HeyPCB/iris-ring/img/iris_ring_3d.jpg

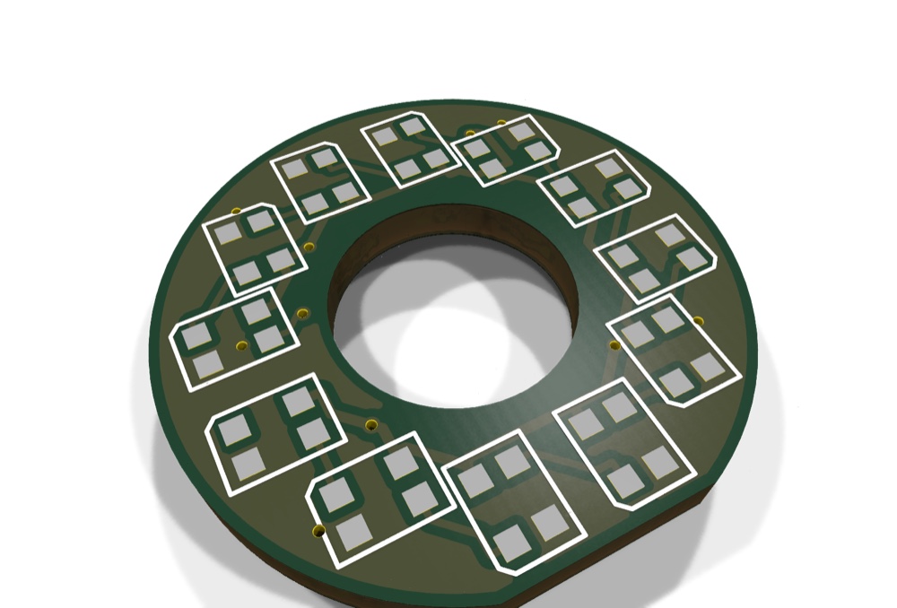
img/iris_ring_3d.jpg
