HeyPCB/iris-ring/media/bottom.png

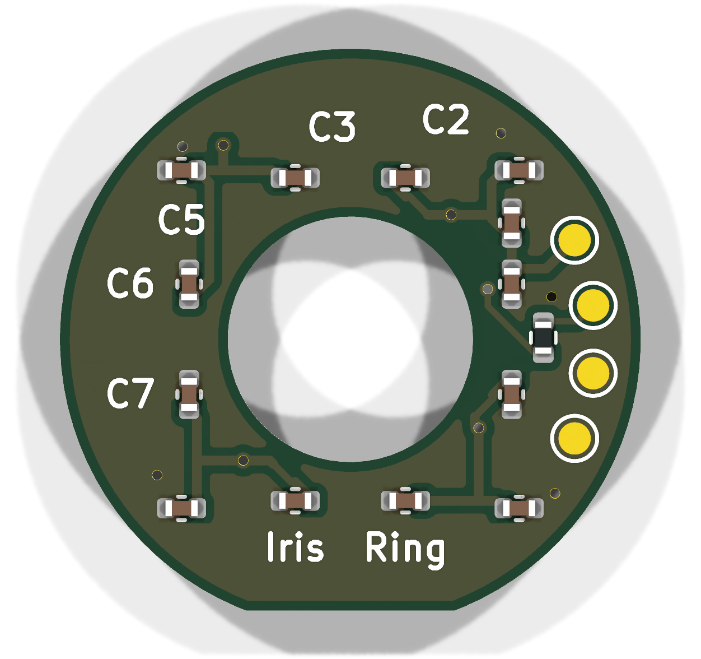
media/bottom.png
