HeyPCB/iris-ring/media/top.png

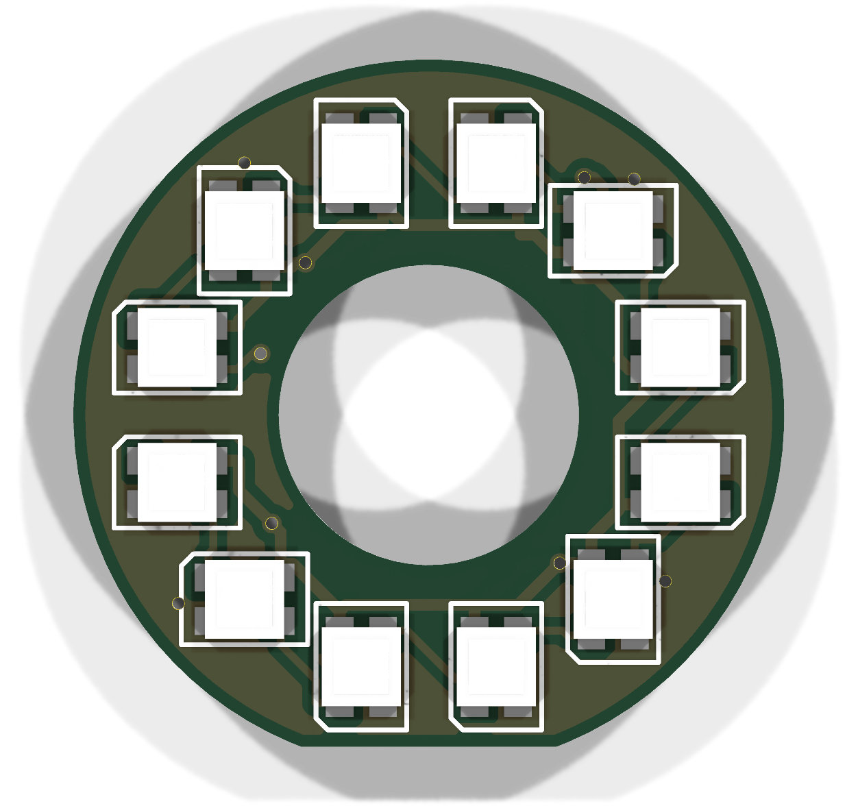
media/top.png
