HeyPCB/iris-ring/fab/iris_ring_bom.csv

Reference | Value | Footprint | MPN | LCSC | Qty
C1,C2,C3,C4,C5,C6,C7,C8,C9,C10,C11,C12 | 100nF | Capacitor_SMD:C_0402_1005Metric | CL05B104KO5NNNC | C1525 | 12
C13 | 4.7uF | Capacitor_SMD:C_0402_1005Metric | CL05A475MP5NRNC | C23733 | 1
D1,D2,D3,D4,D5,D6,D7,D8,D9,D10,D11,D12 | WS2812C-2020-V1 | LED_SMD:LED_WS2812B-2020_PLCC4_2.0x2.0mm | WS2812C-2020-V1 | C2976072 | 12
R1 | 33 | Resistor_SMD:R_0402_1005Metric | 0402WGF330JTCE | C25105 | 1
