HeyPCB/iris-ring/fab/iris_ring.step

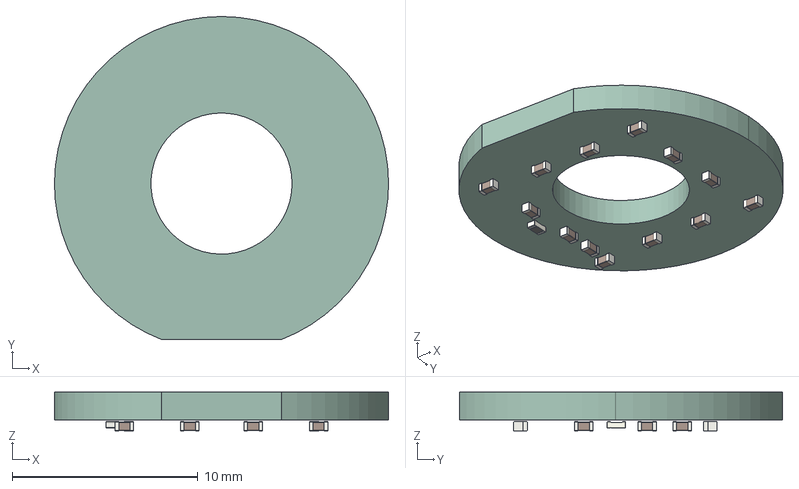
[picture p8: CAD file, 2026-10-03]
fab/iris_ring.step
18.0 x 17.4 x 2.09 mm
C_0402_1005Metric x 13
R_0402_1005Metric
iris_ring_PCB
