HeyPCB/iris-ring/fab/iris_ring_schematic.pdf

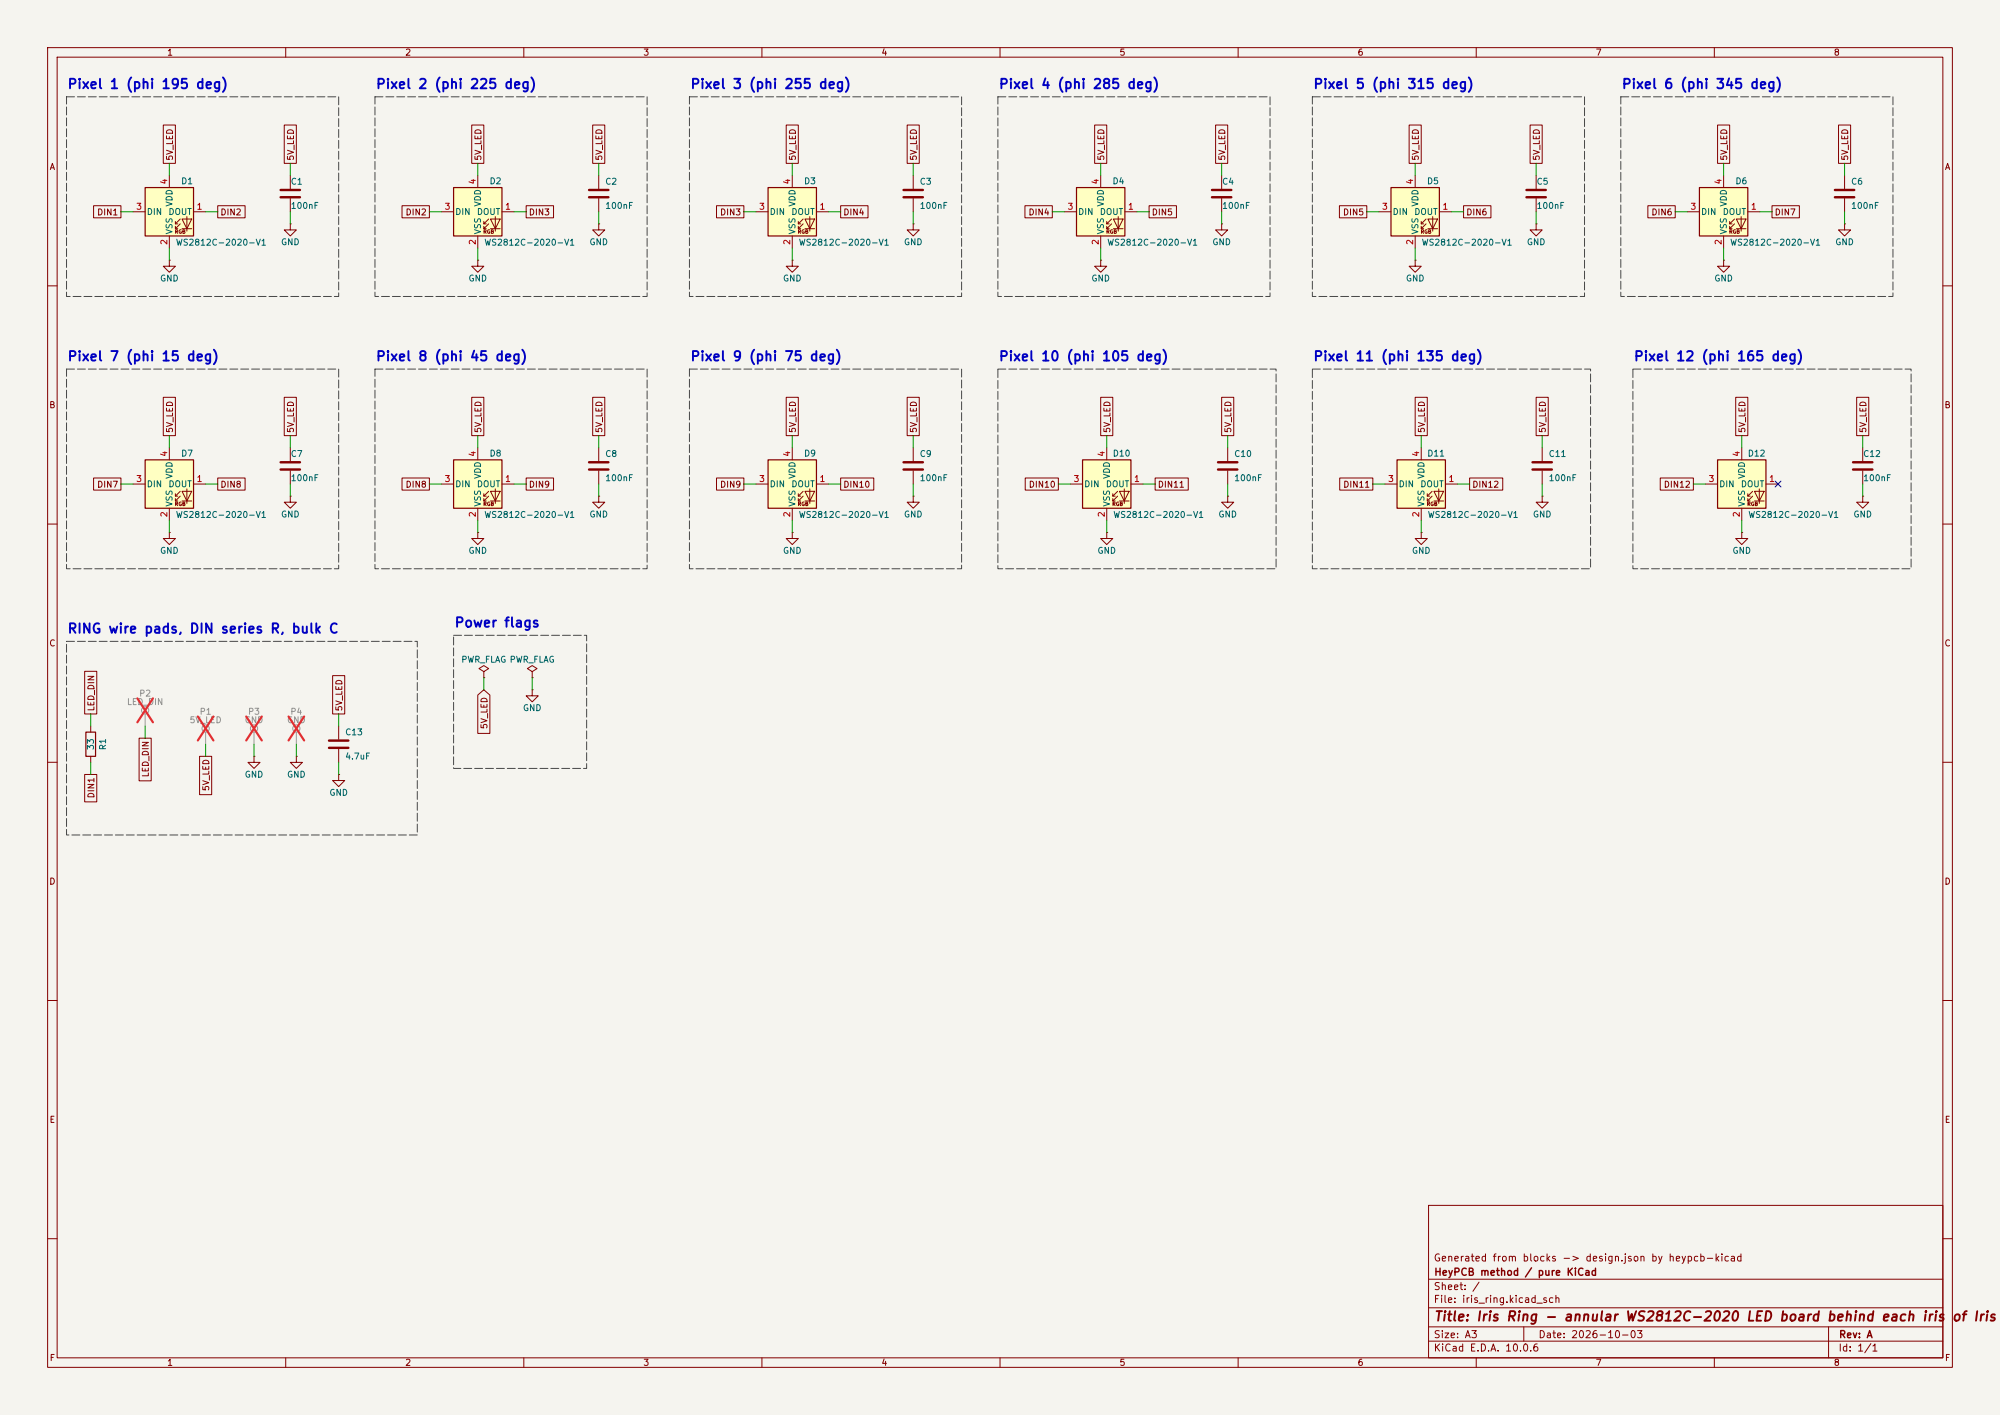
[picture p9: page 1]

RING wire pads, DIN series R, bulk C

Generated from blocks -> design.json by heypcb-kicad
HeyPCB method / pure KiCad
Sheet: /
File: iris_ring.kicad_sch
Title: Iris Ring - annular WS2812C-2020 LED board behind each iris of Iris (B3, fitted twice)

Size: A3 | Rev: A | F Date: 2026-10-03
KiCad E.D.A. 10.0.6 | Id: 1/1
