HeyPCB/iris-ring/kicad/iris_ring.kicad_pcb

## KiCad design kicad/iris_ring.kicad_pcb (2026-10-03)

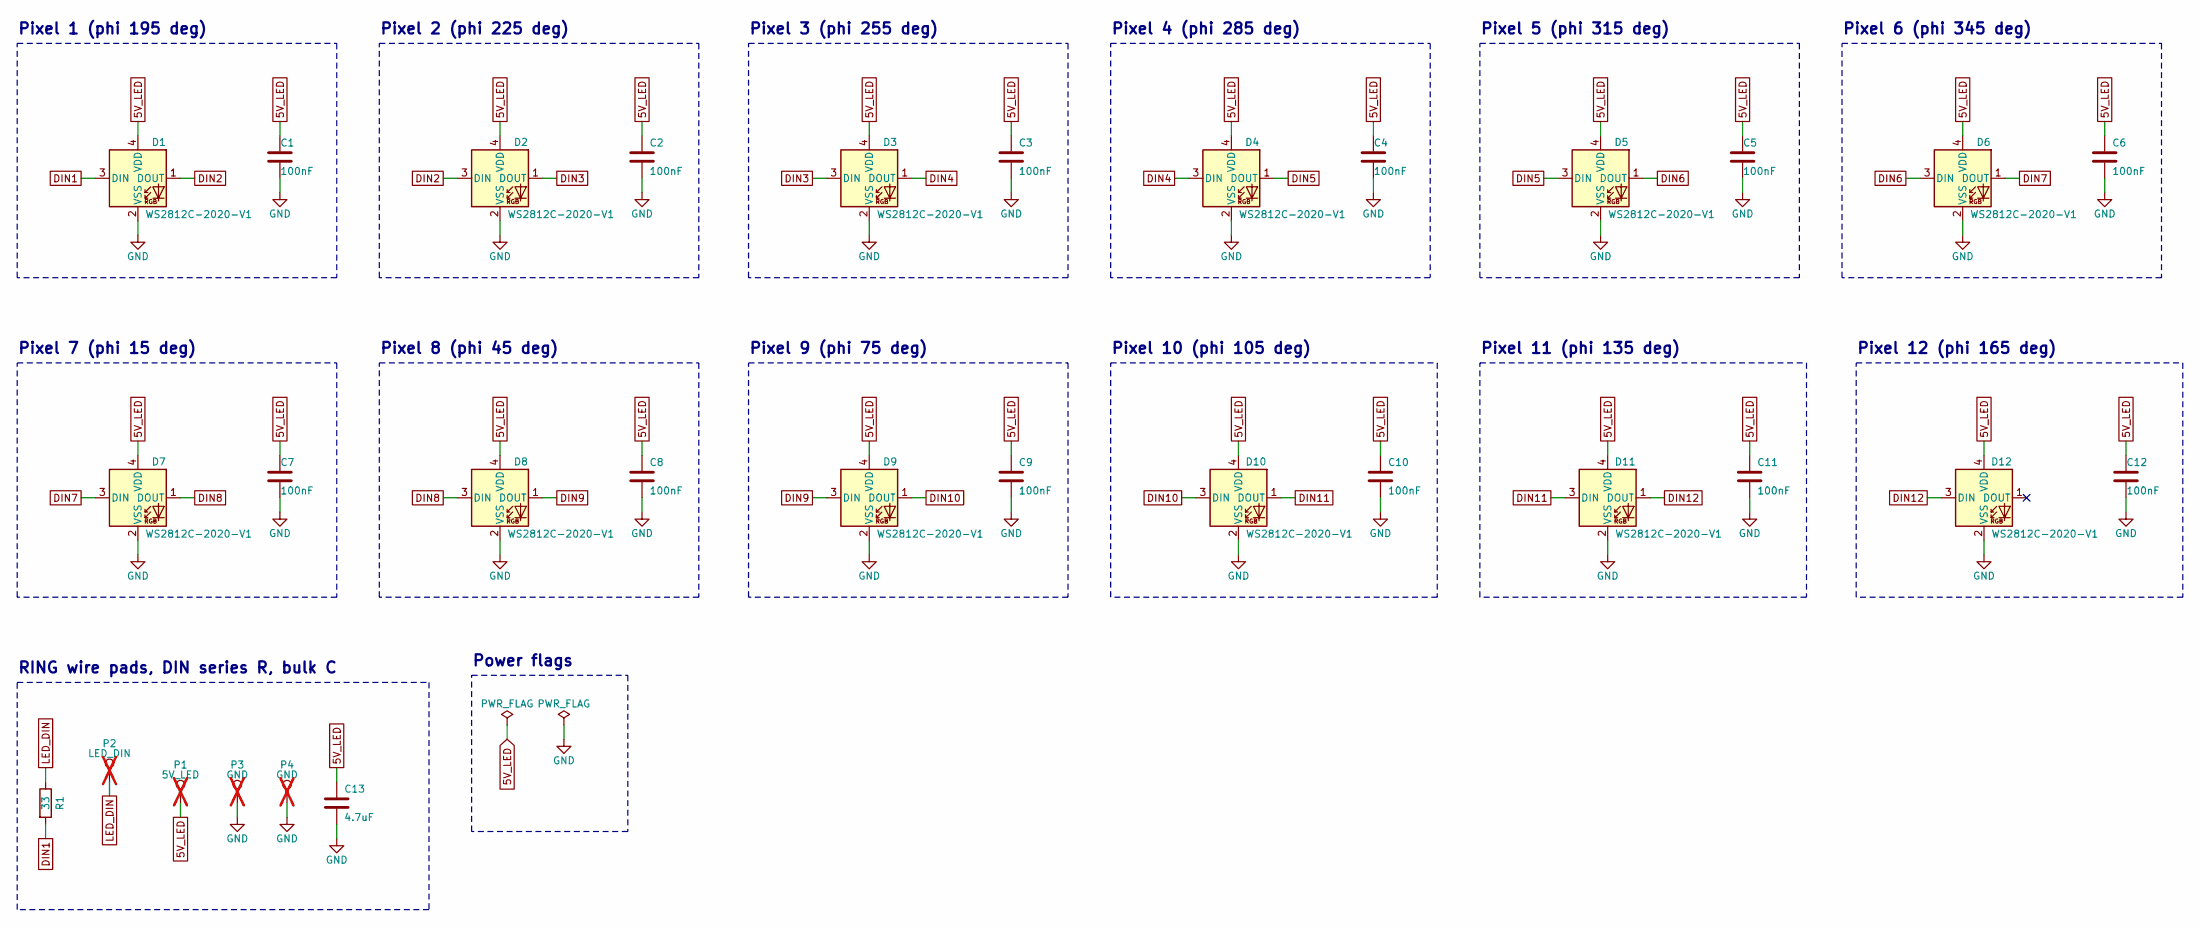
[picture p10: schematic iris_ring.kicad_sch, Iris Ring - annular WS2812C-2020 LED board behind each iris…]

Parts:
C1, C2, C3, C4, C5, C6, C7, C8, C9, C10, C11, C12: 100nF; C_0402_1005Metric; MPN CL05B104KO5NNNC; LCSC C1525
C13: 4.7uF; C_0402_1005Metric; MPN CL05A475MP5NRNC; LCSC C23733
D1, D2, D3, D4, D5, D6, D7, D8, D9, D10, D11, D12: WS2812C-2020-V1; LED_WS2812B-2020_PLCC4_2.0x2.0mm; MPN WS2812C-2020-V1; LCSC C2976072
P1: 5V_LED; TestPoint_Pad_D1.0mm; not fitted
P2: LED_DIN; TestPoint_Pad_D1.0mm; not fitted
P3, P4: GND; TestPoint_Pad_D1.0mm; not fitted
R1: 33; R_0402_1005Metric; MPN 0402WGF330JTCE; LCSC C25105

Connections:
5V_LED: C1.1, C2.1, C3.1, C4.1, C5.1, C6.1, C7.1, C8.1, C9.1, C10.1, C11.1, C12.1, C13.1, D1.4 (VDD), D2.4 (VDD), D3.4 (VDD), D4.4 (VDD), D5.4 (VDD), D6.4 (VDD), D7.4 (VDD), D8.4 (VDD), D9.4 (VDD), D10.4 (VDD), D11.4 (VDD), D12.4 (VDD), P1.1
DIN1: D1.3 (DIN), R1.2
DIN2: D1.1 (DOUT), D2.3 (DIN)
DIN3: D2.1 (DOUT), D3.3 (DIN)
DIN4: D3.1 (DOUT), D4.3 (DIN)
DIN5: D4.1 (DOUT), D5.3 (DIN)
DIN6: D5.1 (DOUT), D6.3 (DIN)
DIN7: D6.1 (DOUT), D7.3 (DIN)
DIN8: D7.1 (DOUT), D8.3 (DIN)
DIN9: D8.1 (DOUT), D9.3 (DIN)
DIN10: D9.1 (DOUT), D10.3 (DIN)
DIN11: D10.1 (DOUT), D11.3 (DIN)
DIN12: D11.1 (DOUT), D12.3 (DIN)
GND: C1.2, C2.2, C3.2, C4.2, C5.2, C6.2, C7.2, C8.2, C9.2, C10.2, C11.2, C12.2, C13.2, D1.2 (VSS), D2.2 (VSS), D3.2 (VSS), D4.2 (VSS), D5.2 (VSS), D6.2 (VSS), D7.2 (VSS), D8.2 (VSS), D9.2 (VSS), D10.2 (VSS), D11.2 (VSS), D12.2 (VSS), P3.1, P4.1
LED_DIN: P2.1, R1.1

Notes on the sheet:
Pixel 1 (phi 195 deg)
Pixel 2 (phi 225 deg)
Pixel 3 (phi 255 deg)
Pixel 4 (phi 285 deg)
Pixel 5 (phi 315 deg)
Pixel 6 (phi 345 deg)
Pixel 7 (phi 15 deg)
Pixel 8 (phi 45 deg)
Pixel 9 (phi 75 deg)
Pixel 10 (phi 105 deg)
Pixel 11 (phi 135 deg)
Pixel 12 (phi 165 deg)
RING wire pads, DIN series R, bulk C
Power flags

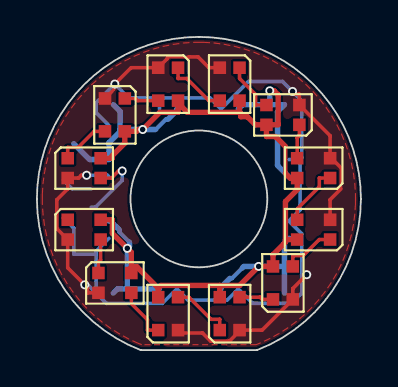
[picture p11: board iris_ring.kicad_pcb from above]

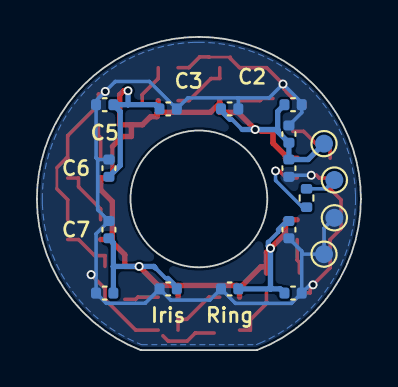
[picture p12: board iris_ring.kicad_pcb from below]

Board: 2 copper layers, 18.0 x 17.4 mm, 30 parts (18 on the bottom side), 15 nets.
